Samarth030312/arduino-water-level-control-lab/README.md

# Arduino water level control lab: tank, pump, HC-SR04, SSR or MOSFET, MATLAB and Simulink

**On-off, P and PI level control of a pumped tank with an Arduino Uno, an HC-SR04 ultrasonic
sensor and a solid-state relay for a mains pump (or a MOSFET for a DC pump on PWM): firmware with
overflow, dry-run and sensor guards, a MATLAB lab app whose physics comes from your tank, outlet
and pump, a Simulink model with the Relay block, an end-to-end test against an emulated rig, and
the first measured session on a real rig.**








A pump fills a tank; water leaves through an outlet at the bottom, faster the fuller the tank
is. An ultrasonic sensor above the water times its echo. An Arduino switches the pump through a
solid-state relay (on below Lmin, off above Lmax) or, for a DC pump, drives it with PWM through a
MOSFET (P, PI). A MATLAB app simulates all of it from the tank, outlet and pump you describe, runs
the same controller on the rig, records it, and draws one over the other. The lab's rig: a 15 L
jar filled from a 500 L tank by a 0.5 HP-class 230 V pump through a Fotek SSR-40DA.

If you are building this rig, this repository takes you from parts to a measured control loop.
If you are not, the simulator and the Simulink model teach the same ideas: a nonlinear,
self-regulating plant, the limit cycle of on-off control, the offset of P, integral action,
saturation and windup, and why a guard belongs in the firmware.

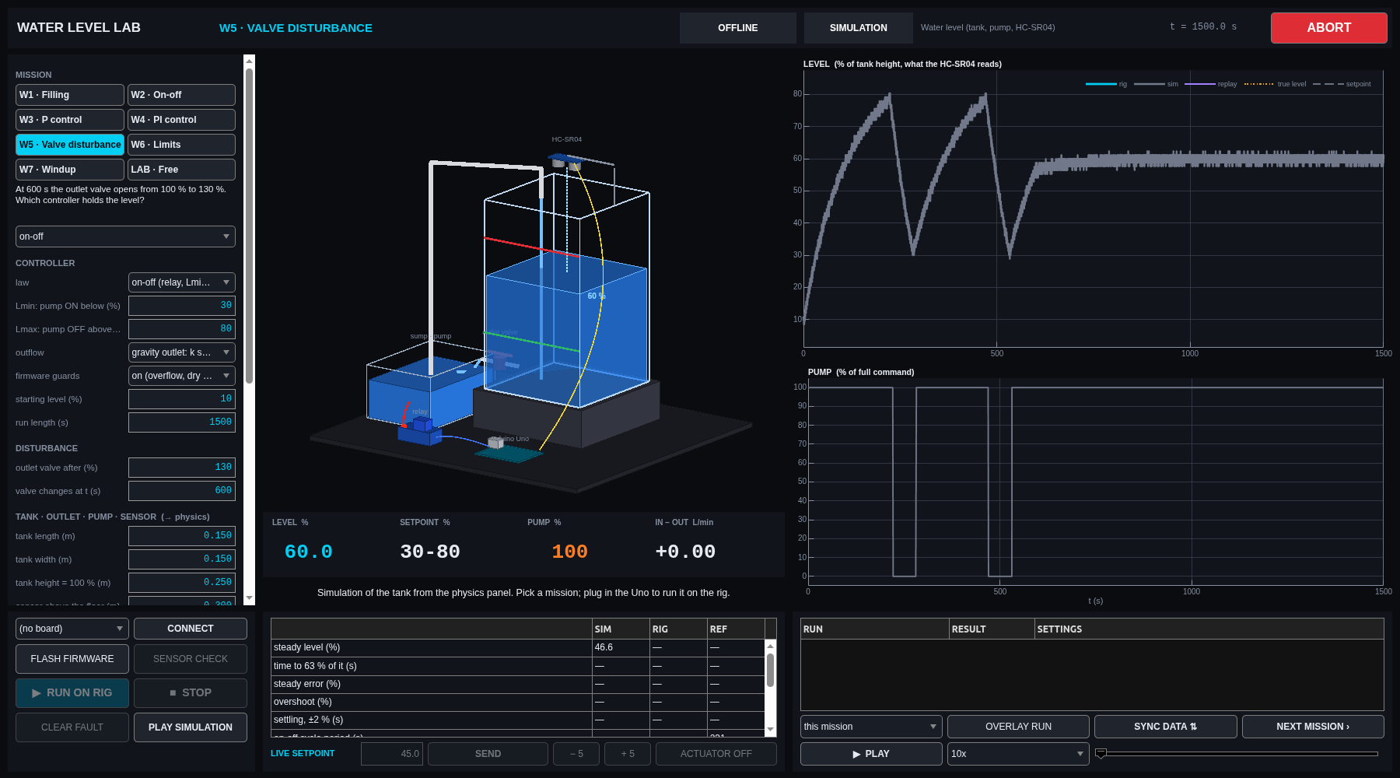
[picture p1: results/figures/app_mission_control.png]
The water_level_lab app: missions W1 to W7 on the left with the controller and the physics panel, the tank in 3-D with the water column, pump, outlet valve and ultrasonic sensor in the centre, the level and the pump command on the right, and the SIM, RIG and REF table at the bottom.


## Get it running

Paste this into the MATLAB Command Window, on Windows, macOS or Linux (MATLAB R2023b or newer):

```matlab
gitclone("https://github.com/Samarth030312/arduino-water-level-control-lab.git", Depth=1); cd arduino-water-level-control-lab; setup open
```

It downloads the repository, checks the computer, installs the project's own Arduino toolchain the
first time (about 60 MB, hash-checked, no admin rights) and opens the app. The simulator needs
only MATLAB. Terminal one-liners and the CH340 driver: **[install](install/README.md)**. Then,
step by step: **[the sequence](docs/SEQUENCE.md)**.

## What the model says

With the default rig (a 15 L jar, 24 × 24 cm, an 8 mm drain, a 0.5 HP-class mains pump at
25 L/min; ESTIMATED until you measure yours; worked out in [first principles](docs/FIRST_PRINCIPLES.md)):

- **The jar regulates itself, but the pump overwhelms it.** The drain's outflow grows with √h
  (2.2 L/min at 30 %, 3.7 L/min at 80 %), so a fixed inflow would settle at h = (q/k)²; the pump
  delivers six times more, and left on it fills the empty jar to the rim in under a minute. Linearised,
  the jar is a first-order lag of 4–6.5 minutes, longer the fuller it is.
- **On-off between 30 % and 80 %** fills in about 22 s and drains in about 2.6 minutes: a cycle of
  ~3 minutes, 22 pump starts an hour; the level overshoots Lmax by ~4 % (water still in the pipe).
- **The pump can only be switched**, not throttled: P and PI need a PWM pump. In simulation, P
  leaves an offset (the drain needs a pump command, and P gives one only with an error), PI removes
  it, and clamping stops the integrator winding up while the pump is saturated.
- **The firmware guards the pump and the floor**: overflow, no filling (dry suction), run time,
  lost sensor, silent host, a hung program, and at most ~200 starts an hour ([wiring](docs/hardware/WIRING.md)).

## What the rig showed (2026-10-26)

Four runs of on-off control ([session](results/reports/water_level/2026-10-26/README.md),
[all against the predictions](docs/RESULTS.md)); the jar had no drain yet and was emptied by hand.

- **On-off works as designed**: pump ON below Lmin, OFF at the first reading above Lmax, in short
  bursts (6–10 s) and long rests (1.5–2 min). The level rose at 1.1–1.5 cm/s, faster than the
  25 L/min estimate gives (0.72 cm/s).
- **The overshoot is 2.8 cm (11–13 %)**, not 1.1 cm: the water kept rising for about 2 s after the
  switch-off. Keep 100 % well under the rim.
- **The HC-SR04 needs care**: pings 10 ms apart heard each other's echoes and started the pump with
  the jar full; one ping per 100 ms with a median filter and a rate gate fixed it. A loose sensor
  lead stopped two runs through the lost-echo guard, as intended.
- **MATLAB and Simulink**, replaying each run with the flows measured in it, agree with each other
  (T_on within 0.2 s) and with the rig's T_on within 1 s.

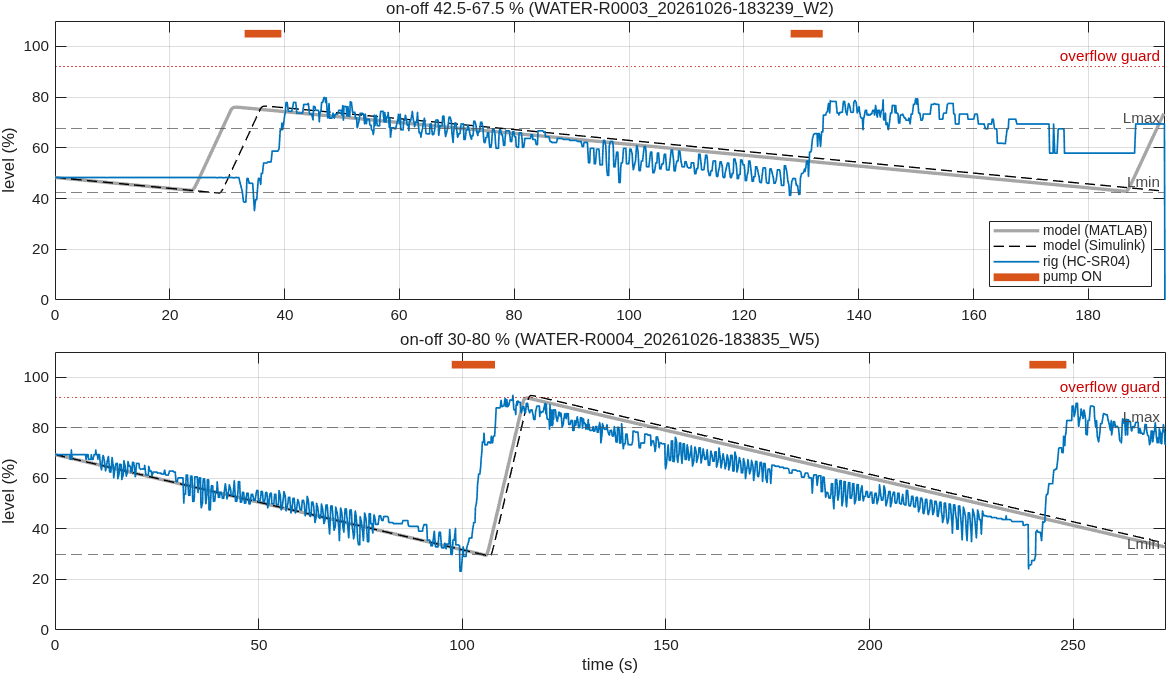
[picture p2: results/reports/water_level/2026-10-26/onoff_cycles.png]
Two on-off runs on the rig: the level in percent against time, the pump-on intervals, the Lmin and Lmax lines, and the MATLAB and Simulink models of each run.


## Start here

| I want to … | Go to |
|---|---|
| understand the simulator, Simulink, the emulator and the rig | [how it works](docs/HOW_IT_WORKS.md) |
| run everything, in order | [the sequence](docs/SEQUENCE.md) |
| install it on Windows, macOS or Linux | [install](install/README.md) |
| use the app, no hardware needed | [the app guide](docs/guide/README.md) |
| run the Simulink model | [Simulink](docs/SIMULINK.md) |
| build and wire the rig | [replicate the rig](docs/REPLICATE.md) and [wiring](docs/hardware/WIRING.md) |
| understand the physics | [first principles](docs/FIRST_PRINCIPLES.md) |
| read the results | [results](docs/RESULTS.md) |
| use the data | [data](data/README.md) |
| fix a problem | [troubleshooting](docs/TROUBLESHOOTING.md) |
| follow the ENR312 course (Ahmedabad University) | [course guide](docs/course/README.md) |
| see what comes next | [roadmap](ROADMAP.md) |

## How it fits together

```mermaid
flowchart LR
    subgraph PC["PC: MATLAB"]
        APP["water_level_lab<br/>app"]
        SIM["simulation<br/>(tank, outlet, pump, sensor,<br/>the firmware's controller)"]
        SL["Simulink<br/>water_level_plant.slx"]
        EMU["emulator<br/>(the firmware compiled for the PC)"]
    end
    subgraph RIG["rig"]
        UNO["Arduino Uno<br/>controller, 0.1 s"]
        RLY["SSR (on-off)<br/>or MOSFET (PWM)"]
        PUMP["pump"]
        TANK["tank, outlet, valve"]
        US["HC-SR04"]
    end
    APP --> SIM
    APP -->|"OPEN IN SIMULINK"| SL
    APP <-->|"USB serial, protocol v1"| UNO
    APP <-->|"the same protocol"| EMU
    UNO -->|"D4 / D5"| RLY --> PUMP --> TANK
    TANK -.->|"echo"| US -->|"D7, D8"| UNO
    APP --> DATA["data/raw<br/>every run, read-only"]
```

## Status

- **Firmware:** on-off through an SSR or relay, P and PI through PWM, the air temperature for the
  speed of sound, guards against overflow (92 %), dry run, run time, lost or jumping echoes and a
  silent PC, minimum on and off times, an optional float switch, the AVR watchdog; compiles in CI
  on Windows, macOS and Linux; runs against an emulated tank, pump and sensor.
- **App and Simulink:** missions W1–W7 and LAB, end-to-end tested against the emulated rig.
- **Rig:** on-off measured on 2026-10-26 (W2, W5). Still to do: a drain on the jar, its
  dimensions, the sensor calibration, W1 and W3–W7 (P and PI need a DC pump on a MOSFET)
  ([open items](docs/knowledge-base/OPEN_ITEMS.md)). The physics defaults stay ESTIMATED until then.

## Repository layout

```
setup.m      one command: path, checks, toolchain, the app (setup open)
firmware/    the Arduino sketch, and the same sketch compiled for the PC against an emulated tank
matlab/      app, physics, controller, metrics, the Simulink model, tests
data/        every rig run (raw CSV, metadata, RUN_REGISTER.csv)
results/     reports and figures
docs/        how it works, physics, hardware, guide, course guide, knowledge base
install/     one-line set-up for Windows, macOS, Linux
```

## Related

Same lab family, same app design: [Rhino DC servo lab](https://github.com/Samarth030312/rhino-rmcs-2303-dc-servo-control) ·
[Arduino temperature control lab](https://github.com/Samarth030312/arduino-temperature-control-lab) ·
[STEVAL-EDUKIT01 rotary inverted pendulum](https://github.com/Samarth030312/steval-edukit).

## License

MIT ([`LICENSE`](LICENSE)). Course handouts are cited, not redistributed.
