Samarth030312/arduino-water-level-control-lab/docs/README.md

# Documentation

| Start here | |
|---|---|
| [How it works](HOW_IT_WORKS.md) | the simulator, Simulink, the emulator and the rig |
| [The sequence](SEQUENCE.md) | everything, in order, with and without hardware |
| [The app guide](guide/README.md) | the screen, the physics panel, the missions of `water_level_lab` |
| [Install](../install/README.md) | one line per system; drivers and fixes |

| Understand | |
|---|---|
| [First principles](FIRST_PRINCIPLES.md) | the physics and the control laws, with numbers |
| [Simulink](SIMULINK.md) | the model, from the app or a script |
| [Results](RESULTS.md) | what is predicted, what is measured |
| [Serial protocol](architecture/SERIAL_PROTOCOL.md) | the wire between the app and the board |

| Build and run | |
|---|---|
| [Replicate the rig](REPLICATE.md) · [wiring](hardware/WIRING.md) | parts, build order, pins, power |
| [Safety](safety/EXPERIMENT_CHECKLIST.md) · [electrical safety](safety/ELECTRICAL_SAFETY.md) | before every run |
| [Troubleshooting](TROUBLESHOOTING.md) | symptom, cause, fix |

| Records | |
|---|---|
| [Data](../data/README.md) · [results](../results/README.md) | every run and every report |
| [Experiment plans](experiments/) | the experiments, written before the rig |
| [Knowledge base](knowledge-base/INDEX.md) · [open items](knowledge-base/OPEN_ITEMS.md) | sources, toolchain, what is not known yet |
| [Data management](DATA_MANAGEMENT.md) · [recording protocol](EXPERIMENT_RECORDING_PROTOCOL.md) · [engineering rules](ENGINEERING_RULES.md) | how runs are named, stored and never edited |
| [Course guide (ENR312)](course/README.md) | the course handout mapped onto this repository |
