Samarth030312/arduino-water-level-control-lab/ROADMAP.md

# Roadmap

| Next | Why |
|---|---|
| The first rig session: calibrate the sensor, W1 to fit the tank, W2 | every number in this repository is a prediction until then |
| A flow meter on the pump line | measure the inflow directly instead of from the level's slope |
| A second tank (coupled tanks) | a second-order, interacting plant from the same parts |
| Feed-forward of a measured outflow | the next step after PI for a valve disturbance |
