Samarth030312/arduino-water-level-control-lab/data/metadata/water_level/WATER-R0001_20261026-175940_W2.png

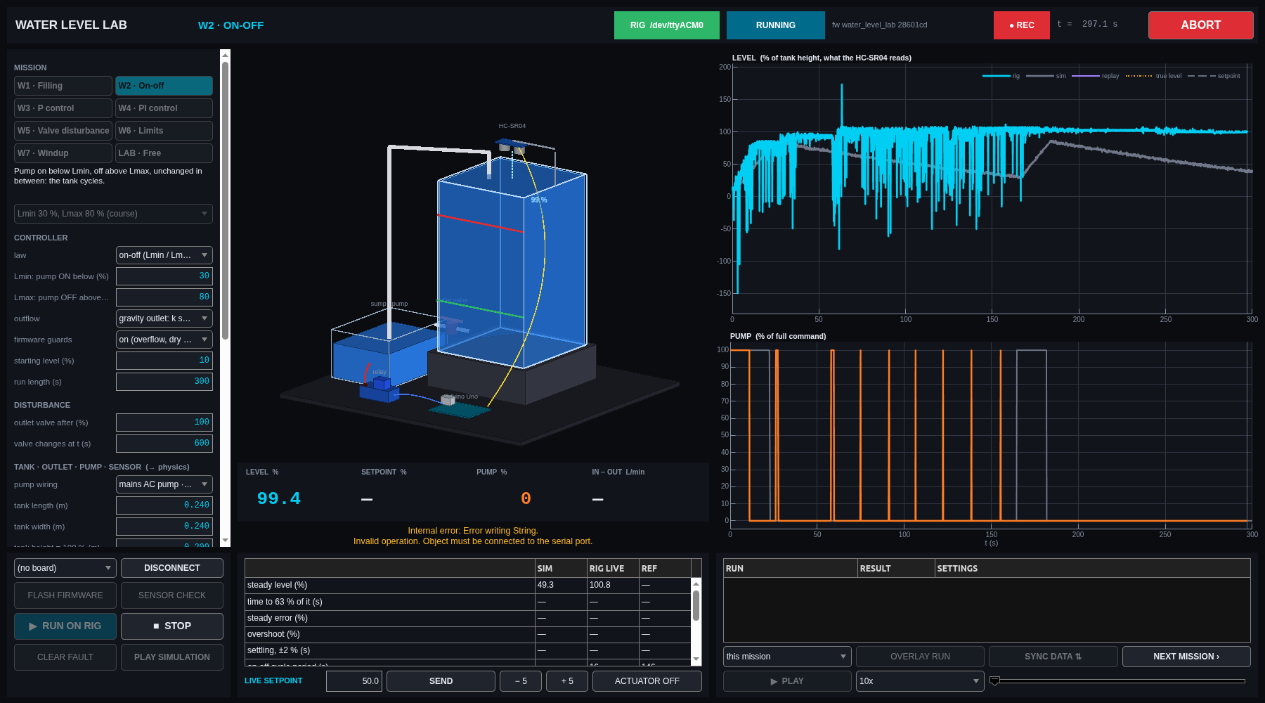
data/metadata/water_level/WATER-R0001_20261026-175940_W2.png
