Samarth030312/arduino-water-level-control-lab/data/metadata/water_level/WATER-R0002_20261026-181809_W2.png

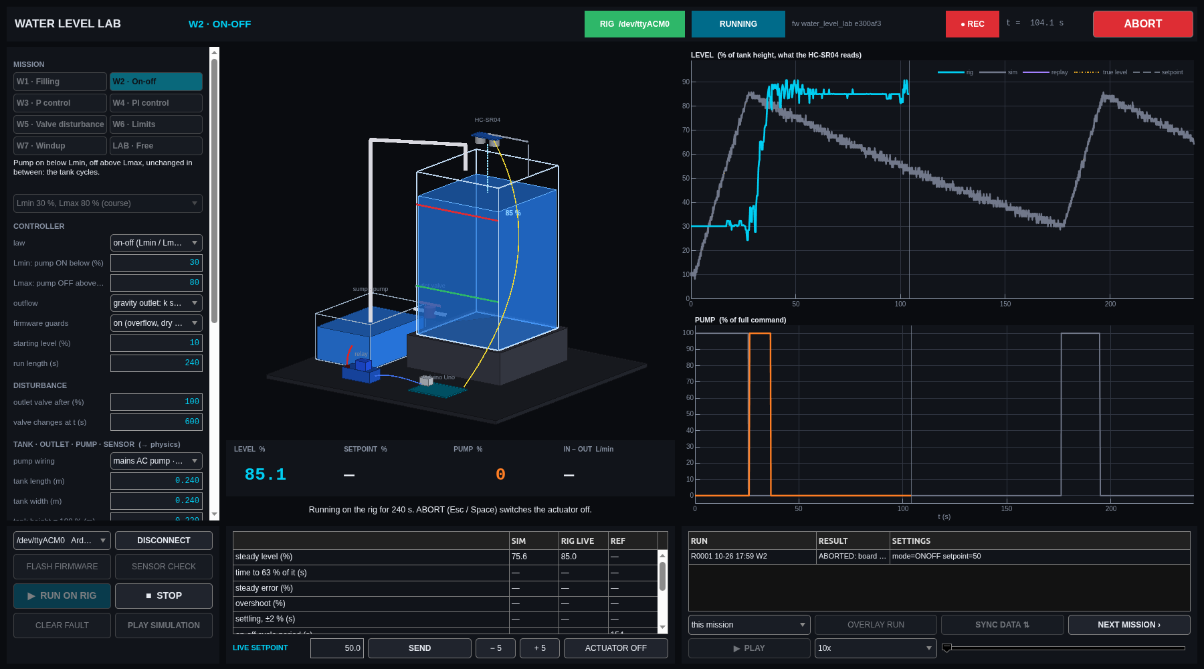
data/metadata/water_level/WATER-R0002_20261026-181809_W2.png
