Samarth030312/arduino-water-level-control-lab/docs/knowledge-base/SOURCE_REGISTER.csv

source_id | title | source_type | manufacturer_or_author | version_or_date | local_path | url | authority | status | notes
SRC-001 | ENR312 Course File (with page numbers) | Course material | Ahmedabad University SEAS | Monsoon 2025-26; 60 pp; sha256 6ef2fbac...821d | docs/references/downloads/ENR312_CourseFile_Monsoon2025_PageNumbers-1.pdf |  | Course requirements | Reviewed 2026-10-09 | DC motor guideline pp.33-34; report format p.42; Assignment 5 p.14; outline weeks 4-5 and 11 p.8.
SRC-004 | Arduino Uno Rev3 | Hardware documentation | Arduino | Online documentation |  | https://docs.arduino.cc/hardware/uno-rev3/ | Official documentation | To review | Confirm board revision by inspection
SRC-010 | Discrete PID Controller block | Software documentation | MathWorks | R2026a |  | https://www.mathworks.com/help/simulink/slref/pidcontroller.html | Official documentation | Referenced | Backward-Euler integrator and filter; clamping anti-windup - matched by pidStep.m
SRC-011 | serialport | Software documentation | MathWorks | R2026a |  | https://www.mathworks.com/help/matlab/ref/serialport.html | Official documentation | Referenced | Used by HardwareLink
SRC-014 | ENR312 Experiment WATER - guidelines and lab report questions | Course material | Ahmedabad University SEAS | 2026-10 | docs/references/downloads/ENR312_Experiment_WATER.pdf |  | Course requirements | Reviewed 2026-10-21 | Section 1 tasks; Section 2 questions; Section 3 additional questions (A apparatus / B simulation / C theory). Not redistributed.
