Samarth030312/arduino-water-level-control-lab/install/linux/README.md

# Linux (Ubuntu / Debian)

## One step

```bash
curl -fsSL https://raw.githubusercontent.com/Samarth030312/arduino-water-level-control-lab/main/install/linux/install.sh | bash
```

It clones to `~/arduino-water-level-control-lab` (or updates it), adds you to the `dialout` group if needed
(serial access, then log out and in once), and starts MATLAB with `setup open`, which
installs the Arduino toolchain into `~/.local/share/arduino-lab-tools` and opens the app.

## By hand

```bash
git clone https://github.com/Samarth030312/arduino-water-level-control-lab.git ~/arduino-water-level-control-lab
sudo usermod -aG dialout $USER        # once, then log out and in
matlab -r "cd('$HOME/arduino-water-level-control-lab'); setup open"
```

Shell helpers (same toolchain as MATLAB): `scripts/setup/acli board list`,
`scripts/setup/upload /dev/ttyACM0` (compile and upload), `scripts/validation/host_tests.sh` (the firmware against its emulated plant, on the PC).

## Notes

- A genuine Uno is `/dev/ttyACM0`; a CH340 clone is `/dev/ttyUSB0`.
- If a CH340 board's port appears and vanishes a second later, `brltty` took it:
  `sudo apt remove brltty`.
- `ffmpeg` (`sudo apt install ffmpeg`) turns the app's recordings into MP4; without it
  they stay AVI.
