Samarth030312/arduino-water-level-control-lab/docs/guide/img/w1_filling.png

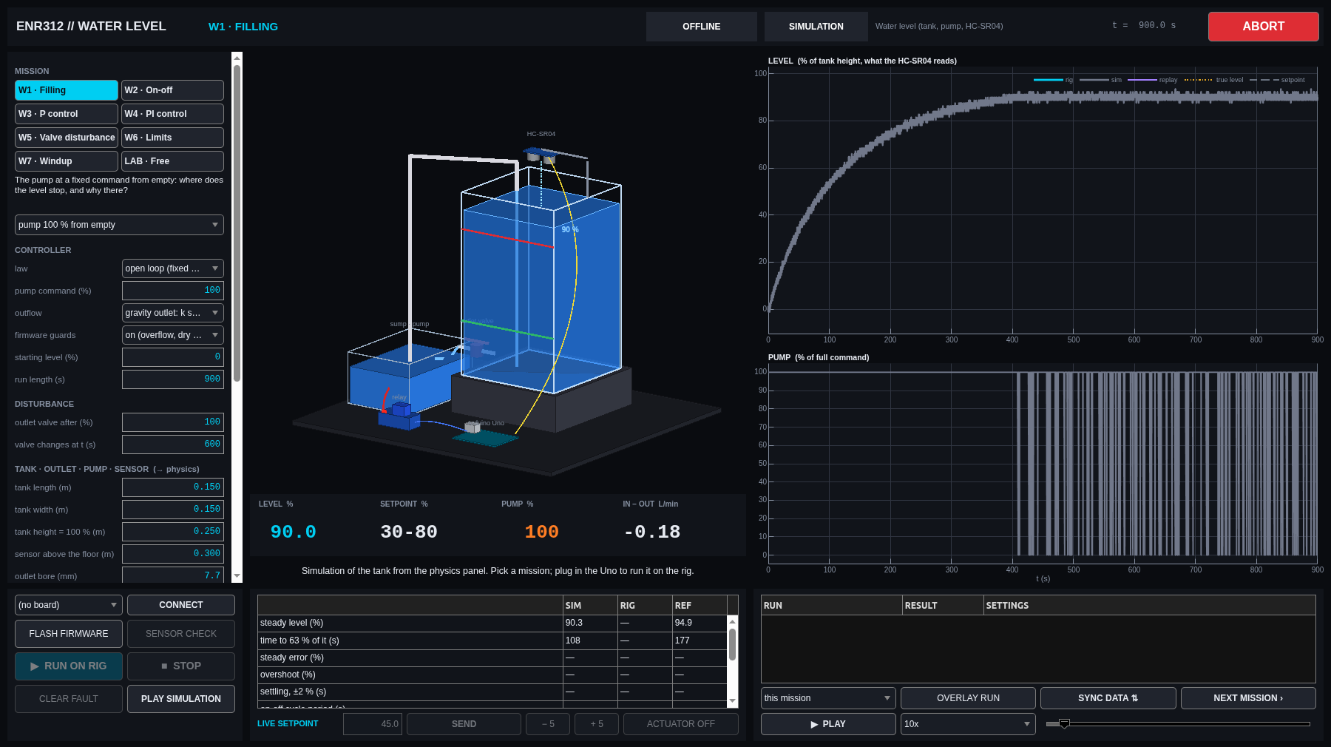
docs/guide/img/w1_filling.png
