Samarth030312/arduino-water-level-control-lab/docs/guide/img/w2_onoff.png

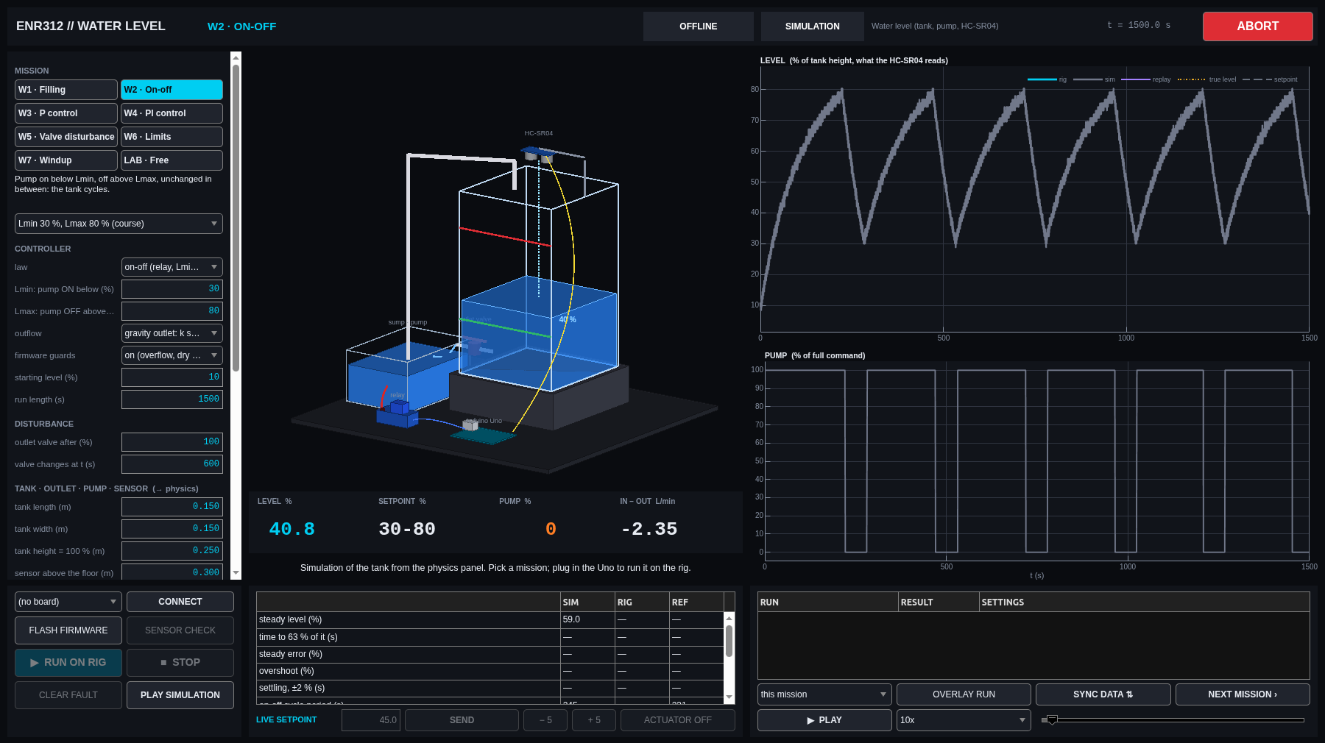
docs/guide/img/w2_onoff.png
