Samarth030312/arduino-water-level-control-lab/docs/guide/img/w6_overflow.png

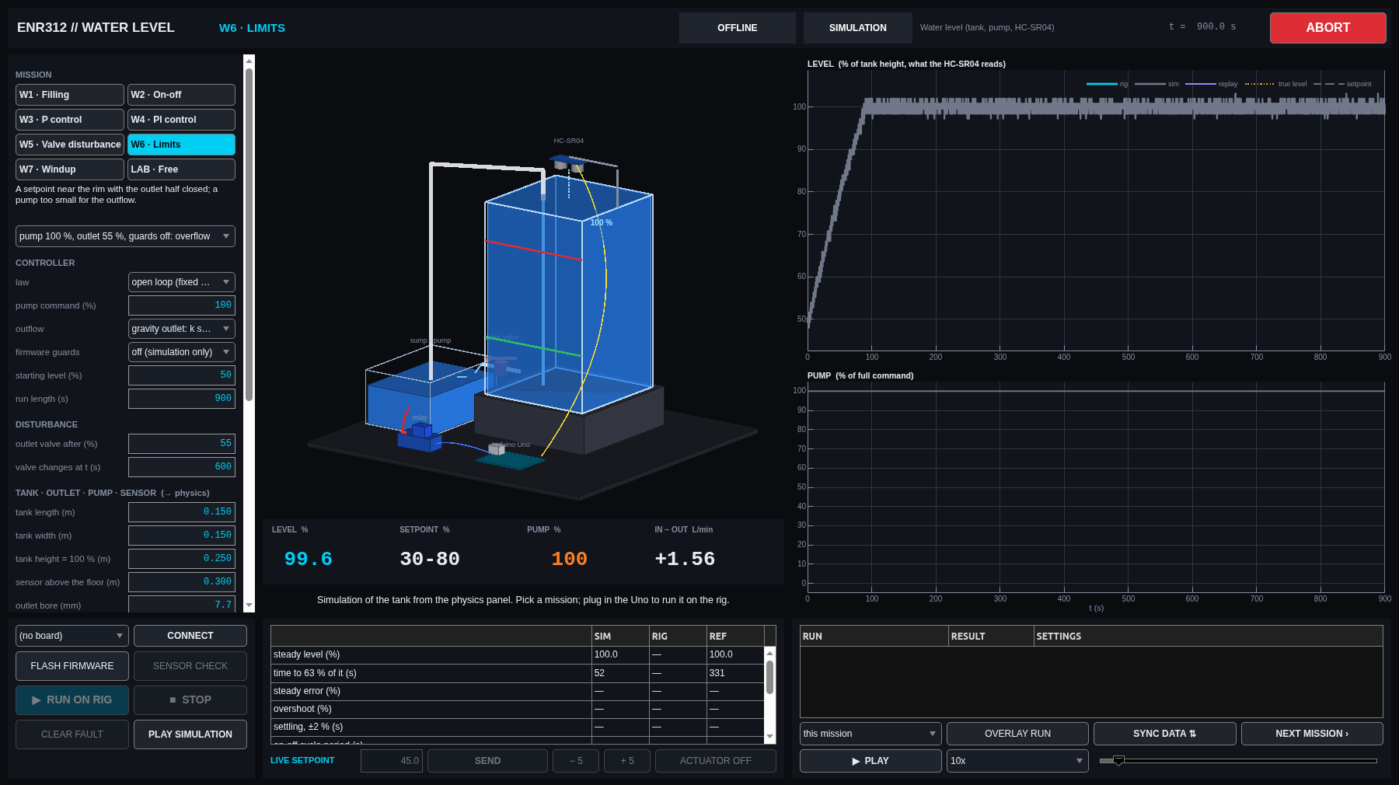
docs/guide/img/w6_overflow.png
