Samarth030312/arduino-water-level-control-lab/docs/experiments/calibration_template.csv

ruler_cm | reading_mean_cm | reading_std_cm | samples | notes
3
6
10
14
18
22
