Samarth030312/arduino-water-level-control-lab/results/README.md

# Results

Reports of rig sessions go to `reports/water_level/<date>/` (generated by
`matlab/scripts/level_session_report.m`), figures to `figures/`, session logs to `evidence/logs/`.
What the rig showed against each prediction: [results](../docs/RESULTS.md).

- `reports/water_level/2026-10-26/`: the first rig session (on-off, four runs).

- `figures/app_mission_control.png`: the app.
