Samarth030312/arduino-water-level-control-lab/(commit log)

2026-10-24 Arduino water level control lab: tank, DC pump, HC-SR04, relay, MATLAB and Simulink
    Firmware with its safety cut-offs, the mission-control app with physics from the parts you
    describe, a Simulink model generated from code, the firmware tested on the PC against an
    emulated rig, one-line set-up for Windows, macOS and Linux, and CI on all three.
    [RUN_REGISTER.csv, SOURCE_REGISTER.csv, calibration_template.csv]
2026-10-24 fix(io): a frame appended by a timer tick while the telemetry table is built no longer breaks it
2026-10-26 The lab rig: a mains pump through an SSR, a 15 L jar, an HC-SR04
    - firmware: PUMP_PWM / RELAY_ACTIVE_LOW builds (default: SSR, on-off, active HIGH); P and PI refused
    on an on-off actuator; minimum on/off times; no-filling guard per window in cm; run-time guard;
    overflow within 4 cm of the sensor; calibration in EEPROM, $ZERO, RUN refused until calibrated;
    $GRD; AVR watchdog; host tests for both builds
    - app: pump wiring choice sets the build; run check; acknowledged commands; firmware stops end the
    run; simulator mirrors the guards, spills at the rim; rig defaults (ESTIMATED)
    - docs: wiring (switched socket, earth, RCD, fuse, heatsink, plumbing, levels), first principles with
    the r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
2026-10-26 fix(firmware): HELLO buffer holds a full git revision (the calibrated flag was cut off)
    [level_controller.ino]
2026-10-26 fix(firmware): no ghost echoes - one ping per 100 ms step, median of 5, a gate on how far the water can move; pump ON only after 3 readings below Lmin; overflow reached with the pump on latches
    First rig run (WATER-R0001): three pings 10 ms apart heard each other's echoes in the jar; the
    false low readings started the pump eight times with the jar full (the overflow guard stopped it
    each time). Emulator: ghost echoes; tests: a full jar with 30 % ghost pings never starts the pump.
    Session script level_rig_session.m.
    [RUN_REGISTER.csv, WATER-R0001_20261026-175940_W2.csv]
2026-10-26 fix(firmware): memory corruption on the Uno - message texts in flash (RAM 62 % -> 30 %), every number printed through a bounds-checked formatter, free RAM in HELLO
    Run 2026-10-26 18:13: after a sensor dropout the telemetry turned to garbage (the stack and the
    data ran into each other with 768 bytes left); the graph froze. Session script: several bands in turn.
    [RUN_REGISTER.csv, WATER-R0002_20261026-181809_W2.csv]
2026-10-26 data(WATER): runs R0003-R0003 (2026-10-26)
    [RUN_REGISTER.csv, WATER-R0003_20261026-183239_W2.csv]
2026-10-26 data(WATER): runs R0004-R0004 (2026-10-26)
    [RUN_REGISTER.csv, WATER-R0004_20261026-183835_W5.csv]
2026-10-26 fix(simulink): the on-off relay starts with the pump off, as the firmware does
    The Relay block starts in its off state and the old wiring mapped off to pump on, so a run
    starting inside the band filled at once. The block now sees -level: on below Lmin, off above
    Lmax, off at the start.
2026-10-26 feat(report): level_session_report, a rig session's runs from data/, replayed in MATLAB and Simulink
    Per run: the band and geometry sent, length, pump starts, how it ended; the sensor (frames that
    changed, jumps with the pump off, lost echoes, ripple about the trend and its period); for
    on-off runs with a complete cycle: rise and fall rates, Q_in and Q_out, T_on, T_off, overshoot,
    the equivalent delay, against the formulas and against the run simulated in MATLAB and Simulink
    with the flows measured in it. test_session_report checks the published numbers.
2026-10-26 results: first rig session 2026-10-26 - on-off on the 15 L jar, four runs
    Session page with hypothesis, procedure, measurements, validation and conclusion; generated
    report and figures; RESULTS against the predictions; README, first principles, wiring, open
    items and experiment status brought up to the rig.
2026-10-26 docs: the protocol page describes this lab's commands, codes and guards; motor and temperature leftovers removed from examples
